Skagagr/Haptic_Smart_Knob/Haptic_Knob_Host/README.md

# 力反馈旋钮上位机（Haptic_Knob_Host）

基于 **C# WinForms (.NET 8)** 的 PC 端上位机，通过 USB-CDC 虚拟串口与 STM32 固件通信，
验证与调试固件的双向通信协议（帧头 + 长度 + CRC8 校验）。

---

## 已实现功能

### 串口通信（USB-CDC）
- 下拉框选择串口 + **刷新端口**按钮（自动枚举可用 COM 口，去重，启动时自动扫描）
- 打开 / 关闭串口（失败弹窗提示，不崩溃）
- 50ms 定时轮询查询角度，转动旋钮实时刷新（轮询静默，不刷日志）
- **失联保护**：串口断开/STM32 复位时自动检测（收到有效响应心跳超时 500ms），
  自动清理连接状态，无需重启软件；重连后自动恢复轮询

### 查询角度
- 自动发送 `GET_ANGLE` 命令帧，解析回包中的角度（float 小端）
- 界面实时显示角度数值

### 预设切换
- 5 种预设一键切换（COARSE_6 / NORMAL_12 / FINE_24 / DENSE_48 / SMOOTH）
- 发送 `SET_CONFIG` 命令，旋钮运行中实时切换卡位手感
- 显示 ACK 结果（成功 / 状态码）
- 连接串口时默认自动设为 **FINE_24**

### 音量控制
- 角度差检测：转旋钮累加满一个卡位 → 音量 ±1%
- TrackBar 滑块 + 百分比数值实时显示，可拖动反向设置音量
- **音量控制模式**（复选框）：勾选时向固件发 `SET_LIMIT_MODE=0` 关闭限位，
  旋钮可无限旋转连续调音量；取消时恢复双边限位（-180°~360°）

### 亮度控制
- 与音量控制同逻辑：转旋钮累加满一个卡位 → 亮度 ±1%
- 通过 WMI 读写屏幕亮度（`WmiMonitorBrightness`），后台线程节流写入，旋转流畅不卡界面
- **亮度控制模式**（复选框）：勾选时同样关闭限位无限旋转
- 音量 / 亮度模式**互斥**（勾选一个自动取消另一个）

### 步进间隔（随预设自适应）
| 预设 | 每卡位角度 | 音量/亮度步进间隔 |
|---|---|---|
| COARSE_6 | 60° | 每 60° ±1 |
| NORMAL_12 | 30° | 每 30° ±1 |
| FINE_24 | 15° | 每 15° ±1 |
| DENSE_48 | 7.5° | 每 7.5° ±1 |
| SMOOTH | 3.6°（360/100） | 每 3.6° ±1，一圈正好调完 |

### 收发日志
- 时间戳 + hex 帧显示
- **不记录**角度轮询帧（角度已在 UI 显示），仅记录预设切换 / 限位模式等命令

### 蜂鸣器开关
- 勾选框控制旋钮蜂鸣器（默认开启）
- 取消勾选 → 发 `SET_BUZZER=0` 同步下位机，卡位/限位蜂鸣静音

---

## 软件架构

### 分层设计

```
┌────────────────────────────────────────────┐
│  Form1.cs          界面层                  │
│  - 串口开关 / 定时轮询 / 角度显示            │
│  - 预设按钮 / ACK 显示 / 收发日志           │
└───────────────┬────────────────────────────┘
                │
┌───────────────▼────────────────────────────┐
│  KnobProtocol.cs   协议层                  │
│  - CRC8 计算（多项式 0x07）                 │
│  - 帧构建 BuildFrame / 具体命令封装          │
│  - KnobFrameParser 逐字节解析状态机          │
└────────────────────────────────────────────┘
```

### 文件结构

```
Haptic_Knob_Host/
├── Form1.cs                  # 主窗口（界面 + 事件逻辑）
├── Form1.Designer.cs         # 设计器布局（VS 自动生成）
├── Form1.resx
├── Program.cs                # 程序入口
├── Haptic_Knob_Host.csproj   # 工程文件（.NET 8 + System.IO.Ports + NAudio + System.Management）
├── Protocol/
│   └── KnobProtocol.cs       # 协议层：CRC8 + 组帧 + 帧解析
└── Volume/
    ├── VolumeController.cs   # 系统音量控制器（NAudio CoreAudio 封装）
    └── BrightnessController.cs  # 系统亮度控制器（WMI 封装，后台节流写入）
```

### 协议说明

帧格式与固件 `app_usb_protocol.h` 一致：

```
[0xAA][0x55][Type][Len][Payload 0~255B][CRC8]
```

| 命令 | 类型 | 载荷 | 响应 | 说明 |
|---|---|---|---|---|
| `GET_ANGLE` | 0x03 | 空 | 0x83 | 查询角度，回 4B float（小端） |
| `SET_CONFIG` | 0x02 | 1B = preset (0~4) | 0x82 | 设置预设 |
| `SET_LIMIT_MODE` | 0x04 | 1B = mode (0关闭/1单边/2双边) | 0x84 | 设置限位模式 |
| `GET_STATE` | 0x07 | 空 | 0x87 | 查询状态，回 [模式1B][角度4B] |
| `SET_MODE` | 0x08 | 1B = mode (0空闲/1音量/2亮度) | 0x88 | 设置控制模式（同步下位机） |
| `SET_BUZZER` | 0x09 | 1B = 0关/1开 | 0x89 | 设置蜂鸣器开关 |

- 同步头：`0xAA 0x55` 双字节
- CRC8：多项式 0x07，覆盖 Type+Len+Payload
- 响应类型 = 命令类型 | 0x80，响应载荷首字节为状态码
- 轮询用 `GET_STATE` 一次拿模式 + 角度；勾选模式复选框发 `SET_MODE` 同步下位机

---

## 快速开始

1. Visual Studio 打开 `Haptic_Knob_Host.sln`（.NET 8 桌面开发工作负载）
2. 旋钮 USB 插入电脑，在下拉框选择虚拟串口（点"刷新端口"重新扫描）
3. F5 运行 → 选择串口 → 打开串口（自动设 FINE_24）→ 角度实时显示
4. 点预设按钮切换卡位手感；勾选音量/亮度控制模式后转旋钮调音量/亮度

> 依赖 NuGet 包：`System.IO.Ports`、`NAudio`、`System.Management`
> 亮度控制依赖 WMI，笔记本/内置屏通常可用，部分台式机外接显示器可能不支持

---

## 更新日志

### v0.7.0 (2026-08-06)
- 串口稳定性修复：
  - `Write`/`Read`/`Open`/`Close` 全链路异常保护，串口断开不再崩溃（OperationCanceledException 等）
  - **失联看门狗**：以有效状态响应为心跳，超时 500ms 自动判定失联并清理连接状态
    - 解决 STM32 复位后 UI 角度卡死、需重启软件的问题
    - 解决失联后重连不恢复轮询的问题（打开时重新 `pollTimer.Start()`）
  - 修复断开后重连事件未重新注册、角度基准未重置的问题
  - 串口端口枚举去重（避免 STM32 复位后出现重复 COM 口）
  - 关闭窗口时清理串口 + 释放控制器，无后台线程残留
- 代码重构：串口关闭/断开/失联清理统一收敛到 `CloseSerial()`，消除三处重复逻辑

### v0.6.0 (2026-08-05)
- 新增蜂鸣器开关勾选框（默认开启）：勾选/取消 → 发 `SET_BUZZER` 同步下位机

### v0.5.0 (2026-08-05)
- 串口改为下拉框选择 + 刷新按钮（自动枚举可用 COM 口），不再硬编码

### v0.4.0 (2026-08-05)
- 轮询改为 `GET_STATE`：一次获取控制模式 + 角度
- 下位机按钮切换模式 → 上位机轮询读到并同步 UI 复选框（`_syncingMode` 防互斥死循环）
- 上位机勾选音量/亮度 → 发 `SET_MODE` 同步到下位机（点亮对应 LED）
- 协议层新增 `GET_STATE`/`SET_MODE` 命令封装，`KnobControlMode` 枚举移至协议层统一

### v0.3.0 (2026-08-05)
- 新增音量控制：角度差检测 → 每卡位 ±1%，TrackBar 滑块 + 数值显示，NAudio CoreAudio 封装
- 新增亮度控制：WMI 读写屏幕亮度，同音量逻辑；后台线程节流写入，快速旋转不卡界面
- 控制模式改为枚举 `KnobControlMode`（None/Volume/Brightness），音量/亮度互斥，便于后续扩展
- 任一控制模式开启时关闭固件限位（无限旋转），协议层新增 `SET_LIMIT_MODE` 命令封装
- 默认预设改为 FINE_24（连接串口时自动设置）
- SMOOTH 预设步进间隔改为 3.6°（360/100，一圈调完 0~100）
- 日志优化：角度轮询帧不再记录（UI 已有角度），删除查询角度按钮

### v0.2.1 (2026-08-05)
- 代码重构：协议魔法数字抽为枚举（KnobCmd / KnobStatus），响应判断语义化
- Form1 按职责分 region（串口/轮询/发送/解析/命令/日志），抽公共 Send/Log 方法
- 注释精简为方法级摘要，消除重复代码

### v0.2.0 (2026-08-05)
- 协议层 KnobProtocol.cs：CRC8 计算 + 帧构建 + 帧解析状态机
- 接入解析器，自动解析角度并实时显示
- 50ms 定时轮询查询角度
- 预设切换（5 种预设 + ACK 显示）

### v0.1.0 (2026-08-04)
- 初始版本：基础串口收发（打开/关闭串口 + 手动查询 + hex 日志）
