Skagagr/Haptic_Smart_Knob/Haptic_Smart_Knob/Haptic_Smart_Knob.ioc

Mcu.UserName=STM32F103C8Tx
PA0-WKUP.Signal=S_TIM2_CH1_ETR
PA1.Signal=S_TIM2_CH2
PA10.Signal=USART1_RX
PA11.Signal=USB_DM
PA12.Signal=USB_DP
PA13.Signal=SYS_JTMS-SWDIO
PA14.Signal=SYS_JTCK-SWCLK
PA2.Signal=GPIO_Output
PA3.Signal=GPIO_Output
PA4.Signal=GPIO_Output
PA9.Signal=USART1_TX
PB0.Signal=GPIO_Output
PB12.Signal=GPIO_Input
PB13.Signal=GPIO_Input
PB6.Signal=S_TIM4_CH1
PB7.Signal=GPIO_Output
PB8.Signal=GPIO_Output
PB9.Signal=GPIO_Output
PD0-OSC_IN.Signal=RCC_OSC_IN
PD1-OSC_OUT.Signal=RCC_OSC_OUT
