Skagagr/Haptic_Smart_Knob/(commit log)

2026-07-30 n20编码器功能实现
    使用TIM3的编码器模式，开启通道1的2，读取n20电机编码器的值。
    通过7 PPR x 4倍频 x 100减速比计算出电机旋转一圈，编码器的值为2800，最终得出了旋转的角度
2026-07-31 成功实现控制电机的驱动代码
    根据编码器读取的值控制电机，使电机只能在一圈360度内旋转。
    电机电源+接TB6612的AO2，-接AO1，电机编码器A相C1接stm32的PA1，C2接PA0。
    注意：反接可以反转与反向读取编码器数值。
2026-07-31 将main电机代码移动至App层
2026-07-31 更改电机状态命名
2026-07-31 编写tim3 1kHz中断回调以及Debug函数
2026-08-01 初版模拟电机卡位与限位
2026-08-01 增加限位点蜂鸣器音效，优化手感
2026-08-01 角度限位模块、代码分层、去冗余
2026-08-02 重构App层，提升可维护性和用户友好度
    简化配置。从 22 个宏参数简化为 3 个配置字段
    模块化。分层架构，职责单一
    显式状态机。清晰的状态转换逻辑，易于调试和扩展
    事件驱动。 限位模块通过回调通知状态机，解耦设计
    完善注释与文档
    智能蜂鸣。限位激活时卡位检测和 Det# 同步冻结，边界振荡去抖（100ms）
2026-08-03 精简与优化架构
    - 精简架构：13 文件 → 6 文件
    - 合并 ctrl/state/event/isr/types 为单一 app_knob 模块
    - 删除回调模式：limit 模块直接调用，减少间接层
    - 删除未使用的枚举和类型（KnobEventType_t、LimitEventCallback_t）
    - 对外 API 和运行时配置接口不变
2026-08-03 Update 代码讲解与架构设计 - 力矩旋钮篇.md
2026-08-03 新增 USB-CDC 虚拟串口通讯
    硬件接线 + CubeMX 配置 + echo 收发验证通过
2026-08-04 优化注释
2026-08-04 新增 USB 双向通信协议
    - 新增 USB 双向通信协议（`app_usb_protocol.h/c`）
    - 帧格式：`0xAA 0x55` 双字节同步头 + 1 字节长度 + CRC8 校验（多项式 0x07）
    - 接收状态机：跨 USB 包重组 + 校验 + 重同步
    - 命令-应答：`GET_ANGLE` 查询角度（float 小端回传）、`SET_CONFIG` 运行中切换预设
    - 状态码：OK / ERR_LEN / ERR_PARAM / ERR_UNKNOWN
    - `app_usb.c` 由 echo 改为转发协议层解析
2026-08-04 初始版本：基础串口收发
2026-08-05 新增协议层 KnobProtocol
    - 协议层 KnobProtocol.cs：CRC8 计算 + 帧构建 + 帧解析状态机
    - 接入解析器，自动解析角度并实时显示
    - 50ms 定时轮询查询角度
    - 预设切换（5 种预设 + ACK 显示）
2026-08-05 新增切换限位上下限模式命令
    - 新增 `SET_LIMIT_MODE` 命令（0x04）：运行中切换限位模式（关闭/单边/双边）
    - 复用 `KnobLimit_GetConfig/SetConfig`，用于上位机音量/亮度控制模式的无限旋转
2026-08-05 新增音量与亮度控制
    - 新增音量控制：角度差检测 → 每卡位 ±1%，TrackBar 滑块 + 数值显示，NAudio CoreAudio 封装
    - 新增亮度控制：WMI 读写屏幕亮度，同音量逻辑；后台线程节流写入，快速旋转不卡界面
    - 控制模式改为枚举 `KnobControlMode`（None/Volume/Brightness），音量/亮度互斥，便于后续扩展
    - 任一控制模式开启时关闭固件限位（无限旋转），协议层新增 `SET_LIMIT_MODE` 命令封装
    - 默认预设改为 FINE_24（连接串口时自动设置）
    - SMOOTH 预设步进间隔改为 3.6°（360/100，一圈调完 0~100）
    - 日志优化：角度轮询帧不再记录（UI 已有角度），删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
2026-08-05 去除spi1占位，不再考虑使用显示屏
2026-08-05 新增控制模式指示与切换
    - 新增控制模式指示与切换：
    - 新增 BSP 模块 `Knob_Indicator`：LED（PA2 空闲/PA3 音量/PA4 亮度）+ 按键消抖扫描（PB12 回空闲/PB13 切下一状态）
    - 新增 App 模块 `app_mode`：模式状态管理（空闲/音量/亮度）、按钮业务逻辑
    - 按键扫描并入 1kHz 控制循环，模式变化点亮对应 LED
    - 协议新增 `GET_STATE`(0x07) 返回 [模式+角度] 合一、`SET_MODE`(0x08) 上位机同步模式
    - 上位机 50ms 轮询改为 `GET_STATE`，一次拿到模式和角度
2026-08-05 新增和下位机同步控制状态
    - 轮询改为 `GET_STATE`：一次获取控制模式 + 角度
    - 下位机按钮切换模式 → 上位机轮询读到并同步 UI 复选框（`_syncingMode` 防互斥死循环）
    - 上位机勾选音量/亮度 → 发 `SET_MODE` 同步到下位机（点亮对应 LED）
    - 协议层新增 `GET_STATE`/`SET_MODE` 命令封装，`KnobControlMode` 枚举移至协议层统一
2026-08-05 串口改为下拉框选择 + 刷新按钮（自动枚举可用 COM 口），不再硬编码
2026-08-05 添加蜂鸣器开关
2026-08-06 串口稳定性修复
    - `Write`/`Read`/`Open`/`Close` 全链路异常保护，串口断开不再崩溃（OperationCanceledException 等）
    - **失联看门狗**：以有效状态响应为心跳，超时 500ms 自动判定失联并清理连接状态
    - 解决 STM32 复位后 UI 角度卡死、需重启软件的问题
    - 解决失联后重连不恢复轮询的问题（打开时重新 `pollTimer.Start()`）
    - 修复断开后重连事件未重新注册、角度基准未重置的问题
    - 串口端口枚举去重（避免 STM32 复位后出现重复 COM 口）
    - 关闭窗口时清理串口 + 释放控制器，无后台线程残留
    - 代码重构：串口关闭/断开/失联清理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
2026-08-06 删除无用文件
2026-08-06 优化注释新建文档
2026-08-06 去除未使用的pwm通道
2026-08-07 更新文档
