Skagagr/Haptic_Smart_Knob/(notices)

Notices in the files:
Haptic_Smart_Knob/Core/Src/main.c:
Copyright (c) 2026 STMicroelectronics.
All rights reserved.
This software is licensed under terms that can be found in the LICENSE file
